friachi/la-cabine-phone/(commit log)

2023-03-18 protect admin mode; fix init to idle transition; allow volume adj. during PlayNext
    [phone.ino]
2023-03-21 update readme and docs; enhance logging to print settings, also event on rings abandone, and interview fully played back
2023-04-24 add motion detection debug; correct readme for stall and preRing values
    [phone.ino]
2023-07-13 admin mode is accessible only using the internal switch
2023-07-28 Fix bugs with last 3 commits; make pre-ringer default 10 sec
    [phone.ino]
